gda96/CamAssist/hardware/pcb_etch_comparison.png

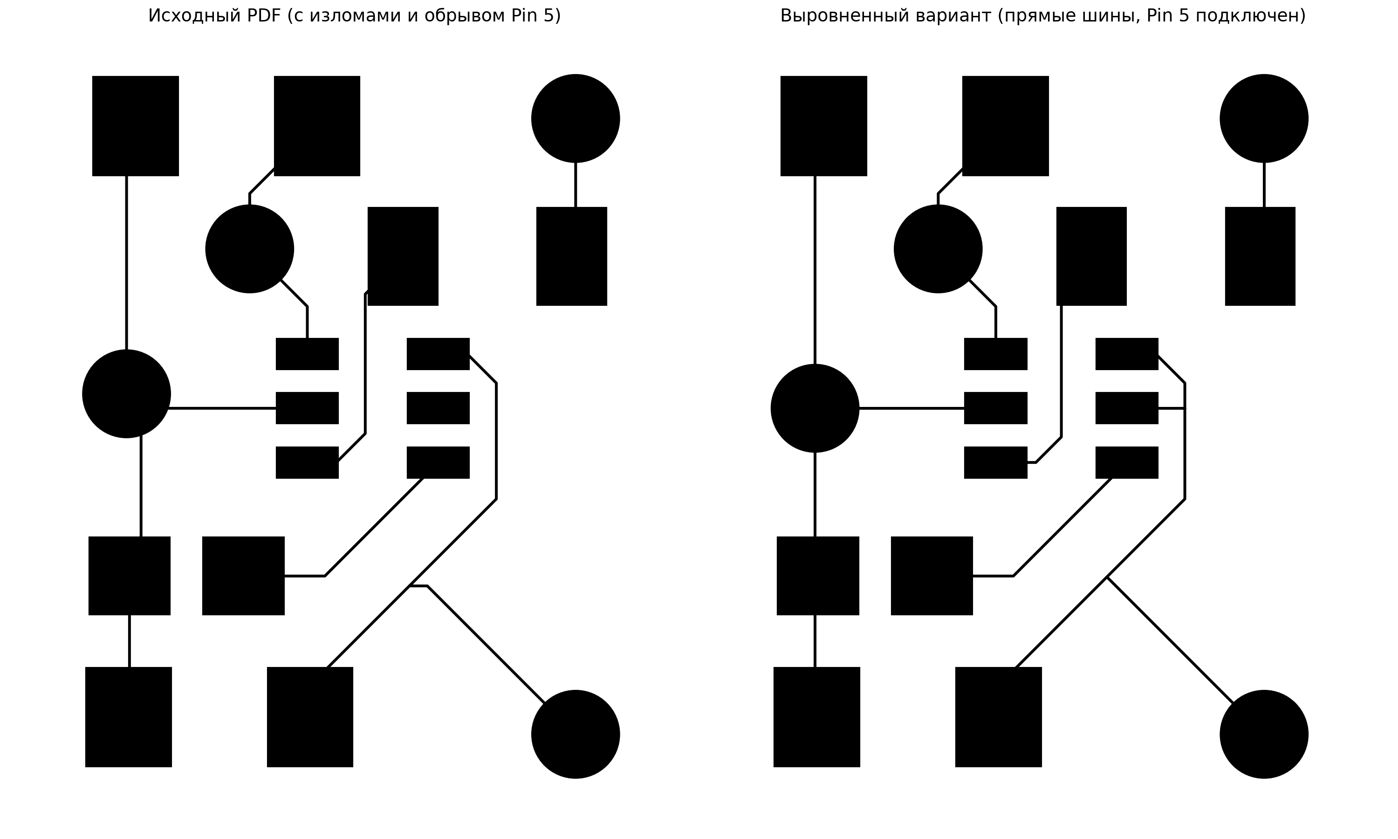
hardware/pcb_etch_comparison.png
