gda96/CamAssist/hardware/tps22810_chip.jpg

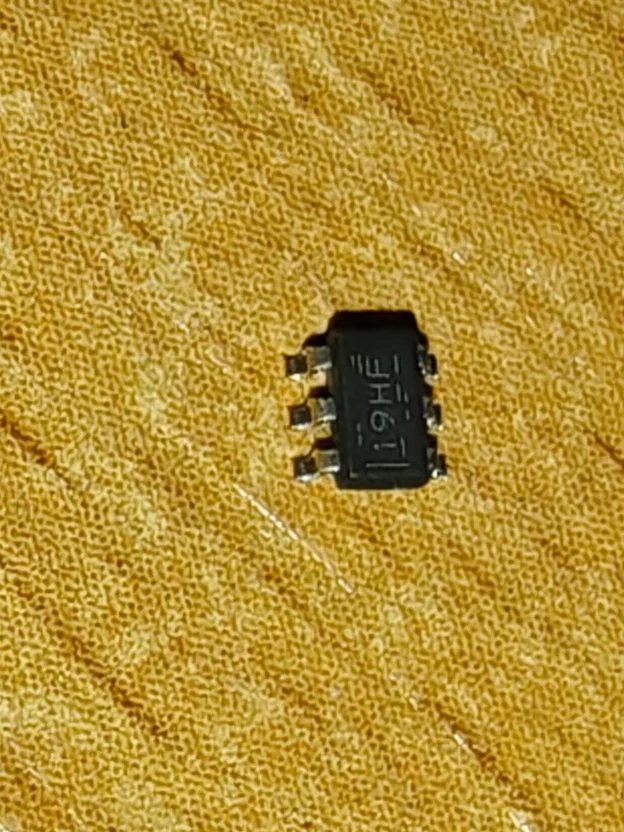
hardware/tps22810_chip.jpg
