gda96/CamAssist/3d_models/Bra-Camera-Sensor-2VAR-GY-21.stl

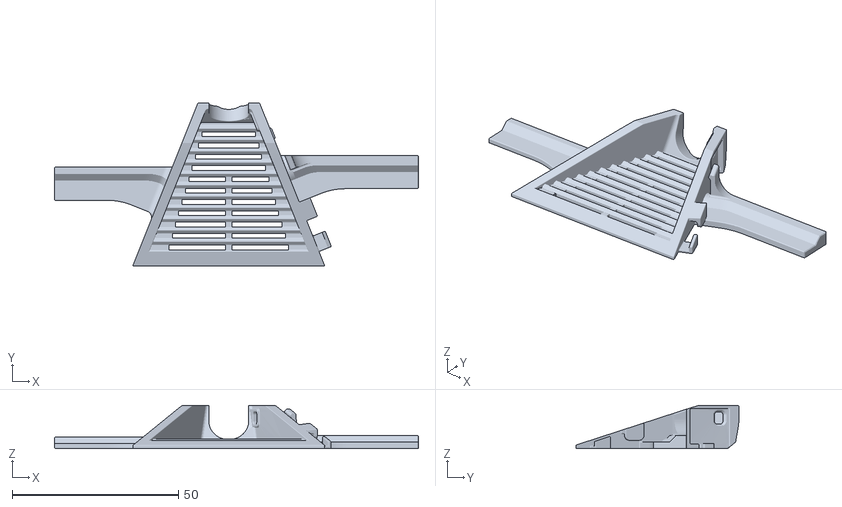
[picture p7: CAD file, 2026-11-06]
3d_models/Bra-Camera-Sensor-2VAR-GY-21.stl
109.5 x 49.1 x 13.0
