gda96/CamAssist/(notices)

Notices in the files:
README.md:
License: MIT
